wencescarlos/reloj-hyrule/AVISO_LEGAL.md

# ⚠️ Aviso legal: proyecto de fans sin ánimo de lucro

## Qué es este proyecto

**Reloj de Hyrule** es un proyecto personal, hecho en casa como regalo para un niño y como **homenaje sin ánimo de lucro** a la saga *The Legend of Zelda*. Se comparte gratis para que otras familias puedan hacer el suyo.

- ❌ **No es un producto comercial.** No se vende ni se venderá.
- ❌ **No se aceptan pagos, donaciones ni patrocinios** relacionados con este proyecto.
- ❌ **No es oficial.** No está creado, aprobado, patrocinado ni relacionado de ningún modo con **Nintendo**, ni con ninguna otra empresa ni sus licenciatarios.
- ✅ Es un proyecto educativo y familiar, de electrónica, impresión 3D y programación.

## Marcas registradas

*The Legend of Zelda*, *Zelda*, *Hyrule*, *Link*, *Trifuerza (Triforce)* y los personajes, nombres y logotipos relacionados son **marcas registradas y propiedad de Nintendo**. Se mencionan solo para identificar el tema del homenaje, sin intención de infringir ningún derecho ni de crear confusión sobre su origen.

## Qué es original en este repositorio

Para evitar cualquier confusión o acusación de plagio, aquí se detalla qué es de creación propia y qué pertenece a otros autores.

| Parte | Autoría | Licencia |
|---|---|---|
| Código del firmware (`firmware/RelojHyrule/`) | **Original**, escrito desde cero para este proyecto. No copia código de otros proyectos | CC BY-NC-SA 4.0 |
| Fuente de letras y dibujos en píxeles (`arte.py`, `fuente.h`, `sprites.h`) | **Original**, dibujado a mano píxel a píxel. No usa sprites, imágenes ni recursos de los juegos | CC BY-NC-SA 4.0 |
| Frases y textos del reloj | **Originales**, salvo algunas referencias breves a frases populares de la saga, a modo de homenaje | CC BY-NC-SA 4.0 |
| Página de configuración | **Original** | CC BY-NC-SA 4.0 |
| Carcasa v2 (`cuerpo_piedra.stl`, `tapa_trasera.stl`, `tapa_trasera_zumbador.stl`, `ventana_difusora.stl`, `barras_sujecion_matriz.stl`, `soporte_wemos.stl`, `soporte_wemos_zumbador.stl`, Trifuerzas doradas) y `generar_modelos.py` | **Originales**, diseñados desde cero | CC BY-NC-SA 4.0 |
| Letras del logo | **De geektoybox** (ver abajo), usadas con su licencia | CC BY-NC 4.0 |
| Música y sonidos | El reloj **no reproduce ninguna música ni sonido** de los juegos. Las melodías del zumbador opcional (`sonido.cpp`) son **composiciones originales** de este proyecto | CC BY-NC-SA 4.0 |

## Créditos a otros autores

| Obra | Autor original | Licencia | Cómo se usa |
|---|---|---|---|
| *Legend of Zelda Logo Text* | **geektoybox**: [Printables](https://www.printables.com/model/499505-legend-of-zelda-logo-text) | CC BY-NC 4.0 | Se incluye **sin cambios** (`logo_letras_geektoybox.stl`). Su contorno se usa para el fondo (`fondo_logo.stl`) y la cresta de la carcasa, y las letras forman parte del logo en una pieza (`logo_dos_colores.stl`). |

Se respeta la licencia CC BY-NC 4.0 del logo: se cita al autor y no hay ningún uso comercial. Las piezas derivadas del logo se comparten con la licencia **CC BY-NC-SA 4.0**, que mantiene ambas condiciones.

Si eres autor de alguna de estas obras y prefieres que se retire o se cambie el crédito, abre un *issue* y se hará enseguida.

## Prohibido el uso comercial

La licencia **CC BY-NC-SA 4.0** (Reconocimiento-NoComercial-CompartirIgual) **prohíbe expresamente**:

- Vender el código, los modelos 3D o los relojes fabricados con este proyecto.
- Usarlo en productos, servicios, tiendas (Etsy, Wallapop, Amazon, Cults...) o campañas con ánimo de lucro.

## Retirada de contenido

Si eres titular de algún derecho (incluido Nintendo) y consideras que algún contenido de este repositorio no debe estar publicado, **abre un *issue* o escribe al autor** y se retirará **sin discusión y de inmediato**.

---

*Este aviso explica la intención del proyecto y da crédito a quien corresponde. No es asesoramiento legal.*
