wencescarlos/reloj-hyrule/imagenes/vista_previa_github.png

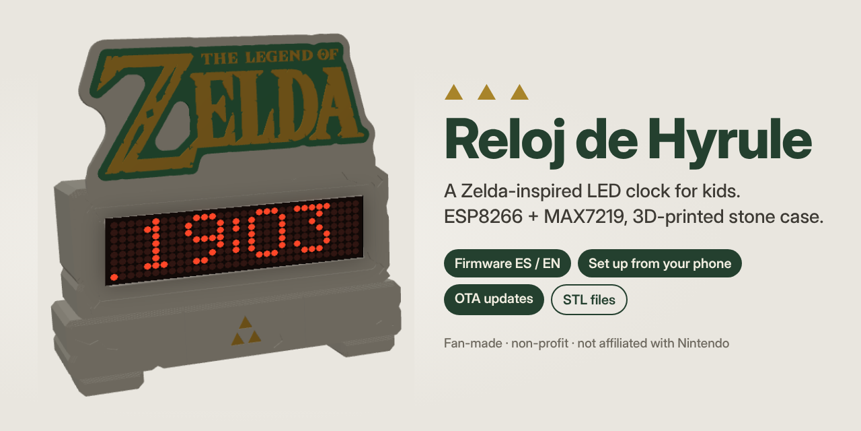
imagenes/vista_previa_github.png
