wencescarlos/reloj-hyrule/modelos_3d/soporte_wemos_zumbador_sin_pines.stl

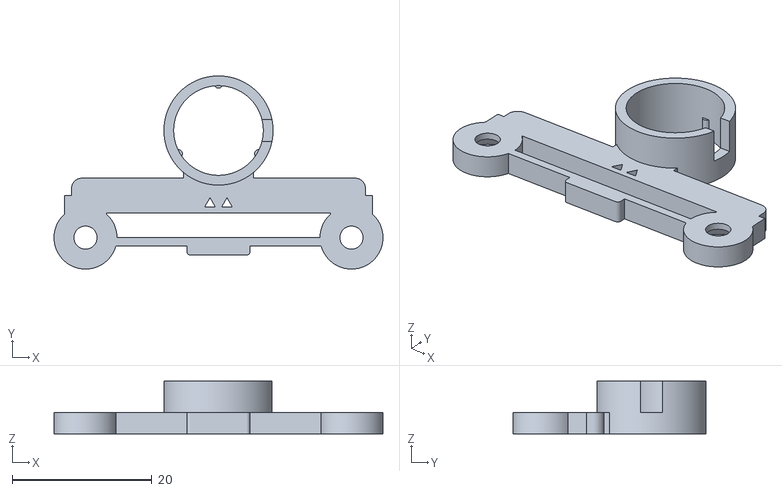
[picture p13: CAD file, 2026-11-02]
modelos_3d/soporte_wemos_zumbador_sin_pines.stl
47.0 x 27.6 x 7.50
