wencescarlos/reloj-hyrule/modelos_3d/tapa_trasera_zumbador.stl

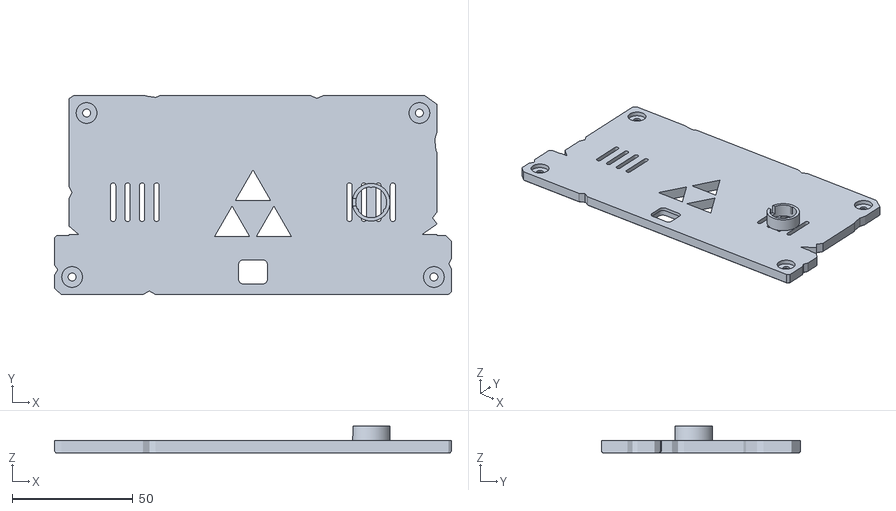
[picture p14: CAD file, 2026-11-02]
modelos_3d/tapa_trasera_zumbador.stl
164.6 x 82.6 x 11.0
