wencescarlos/reloj-hyrule/modelos_3d/soporte_wemos_zumbador.stl

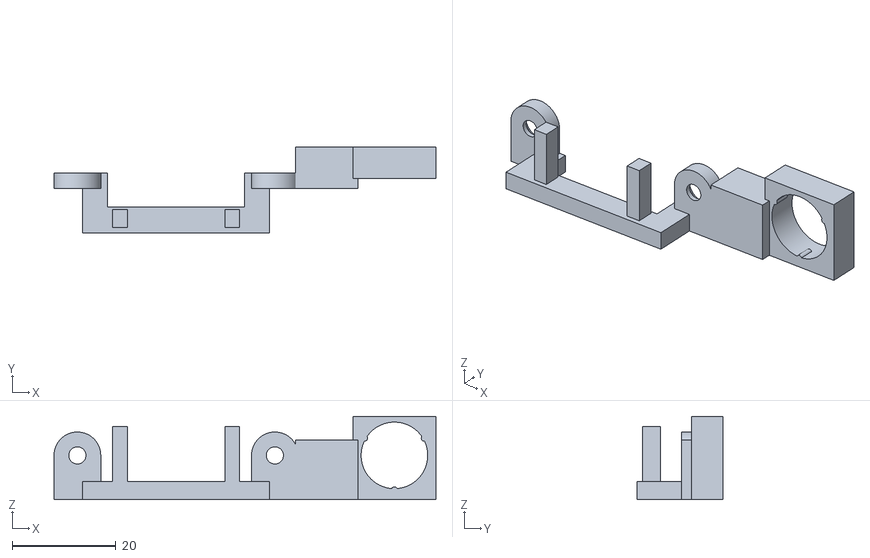
[picture p15: CAD file, 2026-11-02]
modelos_3d/soporte_wemos_zumbador.stl
73.5 x 16.5 x 16.0
