wencescarlos/reloj-hyrule/modelos_3d/ventana_difusora.stl

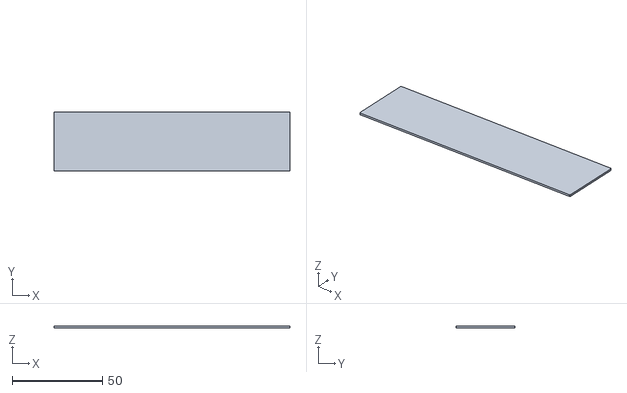
[picture p16: CAD file, 2026-10-25]
modelos_3d/ventana_difusora.stl
131.0 x 33.0 x 1.00
