wencescarlos/reloj-hyrule/modelos_3d/cuerpo_piedra.stl

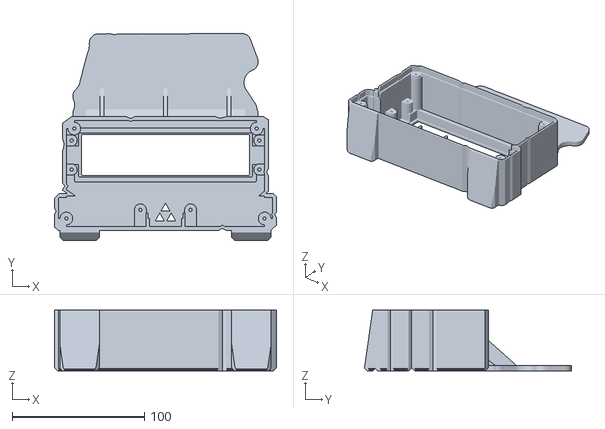
[picture p17: CAD file, 2026-10-25]
modelos_3d/cuerpo_piedra.stl
168.0 x 156.7 x 46.0
