wencescarlos/reloj-hyrule/modelos_3d/logo_dos_colores.stl

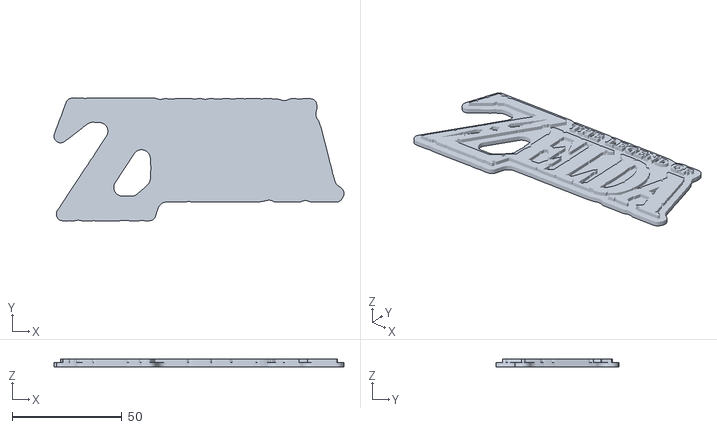
[picture p18: CAD file, 2026-10-24]
modelos_3d/logo_dos_colores.stl
132.2 x 56.0 x 3.50
