wencescarlos/reloj-hyrule/modelos_3d/tapa_trasera.stl

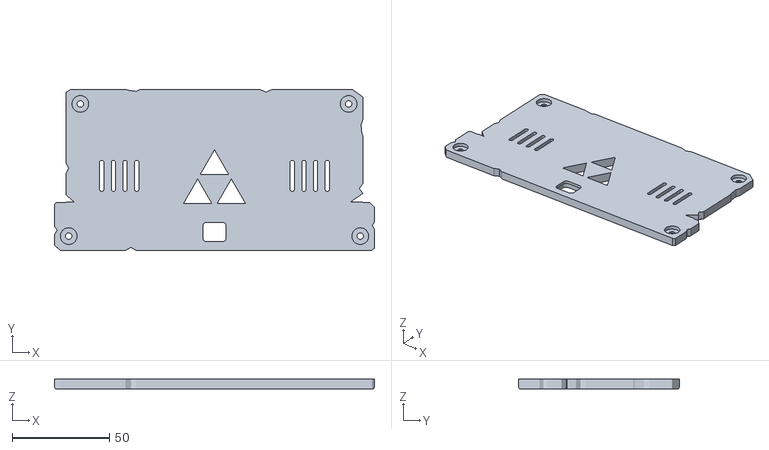
[picture p19: CAD file, 2026-10-19]
modelos_3d/tapa_trasera.stl
164.6 x 82.6 x 5.00
