wencescarlos/reloj-hyrule/modelos_3d/barras_sujecion_matriz.stl

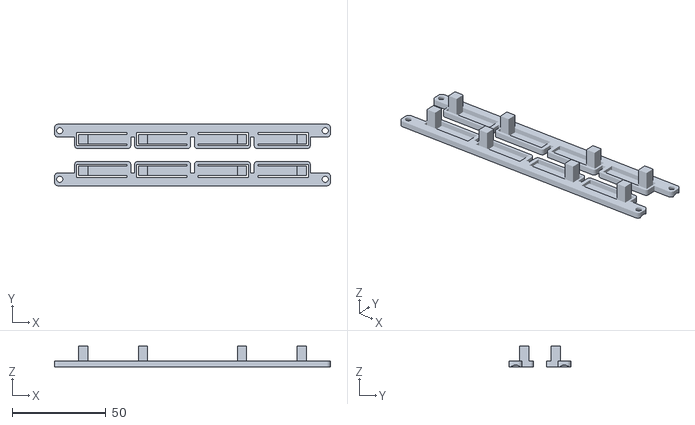
[picture p20: CAD file, 2026-10-19]
modelos_3d/barras_sujecion_matriz.stl
147.6 x 33.0 x 11.0
