wencescarlos/reloj-hyrule/modelos_3d/fondo_logo.stl

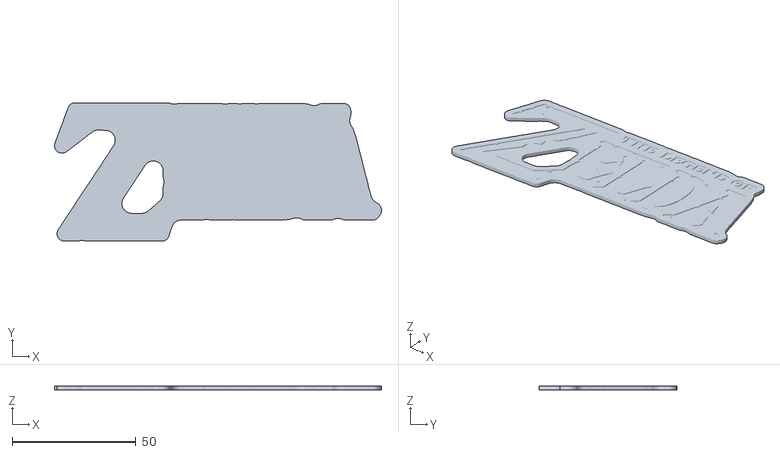
[picture p21: CAD file, 2026-10-19]
modelos_3d/fondo_logo.stl
132.2 x 56.0 x 1.60
