wencescarlos/reloj-hyrule/modelos_3d/soporte_wemos.stl

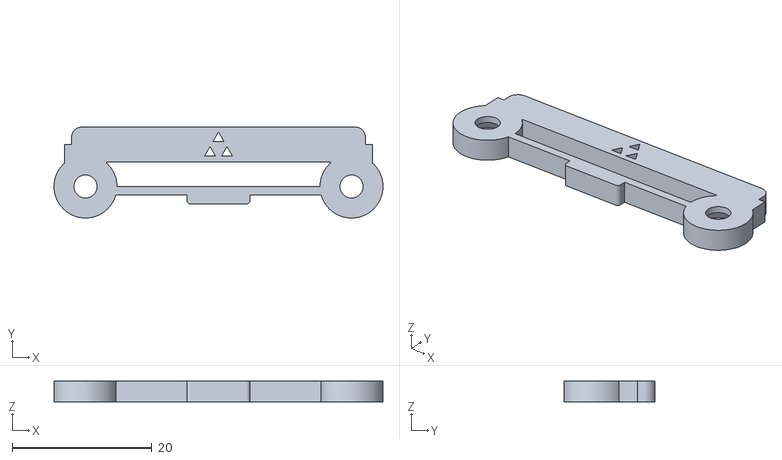
[picture p22: CAD file, 2026-10-19]
modelos_3d/soporte_wemos.stl
47.0 x 13.0 x 3.00
