wencescarlos/reloj-hyrule/modelos_3d/trifuerza_dorada_trasera.stl

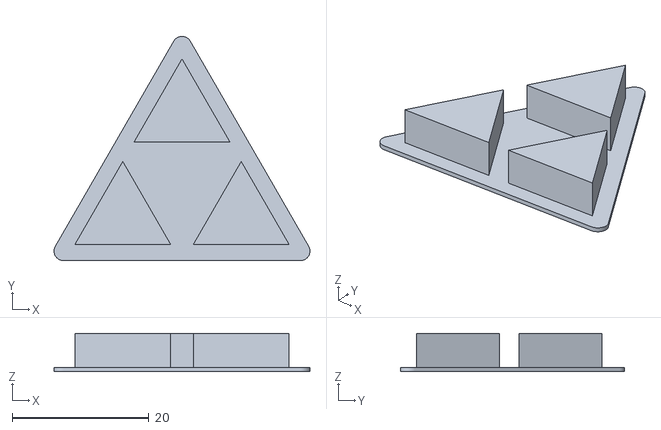
[picture p23: CAD file, 2026-10-18]
modelos_3d/trifuerza_dorada_trasera.stl
37.4 x 32.8 x 5.60
