wencescarlos/reloj-hyrule/modelos_3d/trifuerza_dorada_frontal.stl

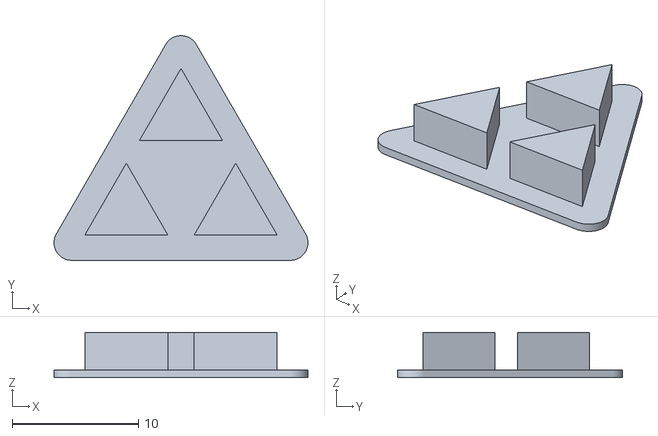
[picture p24: CAD file, 2026-10-18]
modelos_3d/trifuerza_dorada_frontal.stl
20.1 x 17.8 x 3.60
