wencescarlos/reloj-hyrule/modelos_3d/logo_letras_geektoybox.stl

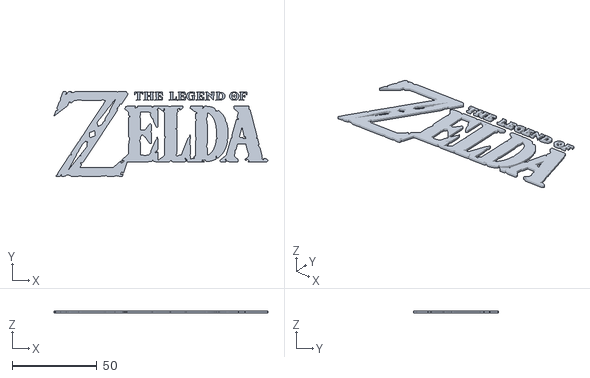
[picture p25: CAD file, 2026-10-18]
modelos_3d/logo_letras_geektoybox.stl
126.2 x 50.0 x 1.28
