wencescarlos/reloj-hyrule/firmware/RelojHyrule/fuente.h

// ===========================================================================
//  fuente.h  -  Fuente propia del Reloj de Hyrule (5x7 proporcional + tildes)
//  Reloj de Hyrule · Proyecto de fans SIN ÁNIMO DE LUCRO · No oficial
//  CC BY-NC-SA 4.0 · https://github.com/wencescarlos/reloj-hyrule
//  Cada glifo se guarda por columnas: bit 0 = fila de arriba (tildes),
//  bits 1..7 = cuerpo de la letra. Archivo generado a partir del dibujo
//  de las letras; no hace falta tocarlo a mano.
// ===========================================================================
#pragma once
#include <Arduino.h>

// Códigos internos de los caracteres especiales (además del ASCII)
#define CAR_CORAZON   0x01
#define CAR_RUPIA     0x02
#define CAR_TRIFUERZA 0x03
#define CAR_DESTELLO  0x04
#define CAR_A_TILDE   128
#define CAR_E_TILDE   129
#define CAR_I_TILDE   130
#define CAR_O_TILDE   131
#define CAR_U_TILDE   132
#define CAR_U_DIERESIS 133
#define CAR_ENIE      134
#define CAR_ABRE_EXCL 135
#define CAR_ABRE_INTERR 136
#define CAR_GRADO     137

const uint8_t FUENTE_DATOS[] PROGMEM = {
  0x18, 0x3C, 0x78, 0x3C, 0x18, 0x38, 0x7C, 0xC6, 0x7C, 0x38, 0x20, 0x30, 0x24, 0x06, 0x24, 0x30,
  0x20, 0x22, 0x14, 0x08, 0x14, 0x22, 0x00, 0x00, 0x00, 0xBE, 0x06, 0x00, 0x06, 0x24, 0x7E, 0x24,
  0x7E, 0x24, 0x46, 0x26, 0x10, 0xC8, 0xC4, 0x6C, 0x92, 0xAA, 0x44, 0xA0, 0x06, 0x7C, 0x82, 0x82,
  0x7C, 0x54, 0x38, 0x7C, 0x38, 0x54, 0x10, 0x10, 0x7C, 0x10, 0x10, 0x80, 0x40, 0x10, 0x10, 0x10,
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
  255, 255, 255, 255, 255, 255, 255, 255, 255, 255, 255, 255, 255, 255, 255, 255
};

// Letras pequeñas 3x5 para el indicador AM / PM
const uint8_t MINI_A[3] PROGMEM = {0x1E, 0x05, 0x1E};
const uint8_t MINI_P[3] PROGMEM = {0x1F, 0x05, 0x02};
