wencescarlos/reloj-hyrule/(commit log)

2026-10-18 Reloj de Hyrule v1.0.0: proyecto de fans sin ánimo de lucro
    Firmware original para Wemos D1 mini + MAX7219, piezas 3D (remezclas
    CC BY-NC 4.0 de la caja de Qrome y del logo de geektoybox, con crédito),
    Trifuerza dorada para la tapa trasera, web de actualizaciones (GitHub
    Pages) y aviso legal. No oficial; sin relación con Nintendo.
    Licencia CC BY-NC-SA 4.0.
    [base_reloj_zelda.stl, fondo_logo.stl, logo_letras_geektoybox.stl, tapa_trifuerza.stl, trifuerza_dorada.stl]
2026-10-18 Carcasa V2
    [cuerpo_piedra.stl, fondo_logo.stl, tapa_trasera.stl, trifuerza_dorada_frontal.stl, trifuerza_dorada_trasera.stl, ventana_difusora.stl]
2026-10-19 Carcasa v2.4: tornillos M3x6 avellanados sin insertos y soporte del Wemos
    - Quitada la mella triangular que atravesaba la carcasa y la tapa.
    - 10 tornillos iguales M3 x 6 autorroscantes de cabeza avellanada allen,
    sin insertos, en agujeros guía de 2,5 mm. Todos entran desde atrás.
    - La tapa se centra con bolsillos en las torretas (3 mm de tapa por tornillo).
    - Nuevo soporte_wemos.stl, atornillado desde atrás, con viga elástica que
    aprieta el blindaje del ESP. Sin pegamento.
    - Borrados los archivos de la v1 que ya no se usaban.
    - README, README.en, LEEME, esquema de tornillería e imágenes actualizados.
    Claude-Session: https://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
    [barras_sujecion_matriz.stl, base_reloj_zelda.stl, cuerpo_piedra.stl, fondo_logo.stl, soporte_wemos.stl, tapa_trasera.stl, tapa_trifuerza.stl, trifuerza_dorada.stl]
2026-10-19 Firmware 1.1.1: recupera el español y el inglés
    El commit "Carcasa V2" había devuelto el firmware a la 1.0.0 y borrado
    el trabajo del commit "English" (83b3bcf). Se recupera entero:
    - Selector de idioma Español / English en la página del reloj.
    - Frases, fecha, animaciones y página web en los dos idiomas.
    - docs/index.html, firmware/LEEME.md y animaciones en inglés.
    - README.md con el enlace a README.en.md y la opción de idioma.
    Versión 1.1.1, mayor que la 1.0.0 publicada y que la 1.1.0, para que
    todos los relojes se actualicen solos.
    Claude-Session: https://claude.ai/code/session_01WdfzgvEswNUDjf3uWauBJy
2026-10-24 Logo en una sola pieza para imprimir en dos colores con pausa
    - Nuevo modelos_3d/logo_dos_colores.stl (opción B): fondo verde de 2,0 mm
    y letras de geektoybox hasta 3,5 mm. Se cambia el filamento a 2,0 mm.
    - generar_modelos.py lo genera (función logo_dos_colores).
    - LEEME con la comparación de las dos opciones y los pasos de la pausa en
    PrusaSlicer, OrcaSlicer, Bambu Studio y Cura. READMEs, licencia y aviso
    legal actualizados.
    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
    [logo_dos_colores.stl]
2026-10-24 Firmware 1.2.0: diagnóstico de pantalla
    - Nuevo apartado "Diagnóstico de pantalla" en la página del reloj (ES/EN):
    encender todos los LED o un módulo cada vez (modo de prueba del MAX7219),
    dejar DIN, CLK o CS a 3,3 V para medirlos con el polímetro y terminar.
    Se cierra solo a los 10 minutos.
    - Patas de la pantalla configurables (DIN, CLK, CS) por si una pata del Wemos
    se estropea, y modo de señales lentas. Con DIN=D7 y CLK=D5 sigue usando el
    SPI del chip; con otras patas, las señales se generan por programa.
    - /api/estado informa de las patas y del diagnóstico. El puerto serie lo
    escribe al arrancar.
    - README: aviso de soldar en la entrada (DIN) de la matriz y cómo usar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
2026-10-25 Firmware 1.2.1: arregla la pantalla apagada (CS en D6)
    CS está en D6 (GPIO12), que es la pata MISO del SPI del ESP8266.
    Pantalla::iniciar() la configuraba como salida ANTES de SPI.begin(), y
    SPI.begin() la convertía en MISO: CS no cambiaba nunca y la matriz no
    aceptaba ninguna orden. Ahora CS se configura después de SPI.begin().
    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
    [configuracion.h, pantalla.cpp]
2026-10-25 Firmware 1.2.2: asistente de orientación de la pantalla
    - En "Pantalla", un asistente recorre las 8 posiciones (giro x espejo) con
    un solo botón: guarda cada posición y enseña 1 2 3 4 durante 6 segundos.
    - /api/prueba?corta=1: solo los números, sin flecha ni texto.
    - El apartado de orientación sale abierto.
    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
2026-10-25 Carcasa: cabe la matriz de 130 mm y la ventana difusora se puede colocar
    - El alojamiento de la matriz pasa de 128,8 x 32,8 a 131,4 x 33,4 mm:
    valen las placas 4 en 1 de 128 a 130 mm.
    - La ventana difusora medía 133 x 37 mm y no pasaba por el marco. Ahora
    mide 131 x 33 x 1 mm: entra por el mismo hueco que la matriz y cae en un
    rebaje de 1 mm del frente. La matriz la aprieta; no se pega.
    - LEEME: nuevo paso de montaje de la ventana con imagen.
    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
    [cuerpo_piedra.stl, ventana_difusora.stl]
2026-10-25 Firmware 1.2.3: la pantalla se recupera sola si se desconfigura
    El Wemos envía señales de 3,3 V y el MAX7219 a 5 V pide al menos 3,5 V,
    así que alguna orden puede llegar mal (calor, ruido, bajones del WiFi) y
    dejar un módulo con caracteres raros hasta reiniciar. Ahora la
    configuración completa (prueba, decodificar, filas, brillo y encendido) se
    reenvía cada segundo desde mostrar(), y el brillo y el encendido se
    recuerdan para reenviarlos igual.
    README: consejos de montaje para una pantalla estable (condensador, cables
    cortos, cargador de 1 A).
    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
2026-10-25 Firmware 1.2.4: arregla el botón de enviar un mensaje
    La función del botón se llamaba igual que la casilla del texto
    (mensajeYa). Dentro del formulario, el navegador encontraba antes la
    casilla que la función y el botón daba el error "mensajeYa is not a
    function": el mensaje no se enviaba nunca.
    - La función pasa a llamarse enviarMensajeYa; aviso pasa a mostrarAviso
    por el mismo motivo (también coincidía con un id).
    - Ahora también se envía al pulsar Intro en la casilla.
    Probado en Chromium con un servidor que imita la API del reloj: todos los
    botones envían su petición y no hay errores en la página.
    Claude-Session: http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
    [configuracion.h, pagina_web.h]
2026-10-25 Firmware 1.3.0: página de mensajes para el móvil (/mensaje)
    - Nueva página http://reloj-hyrule.local/mensaje, pensada para añadirla a
    la pantalla de inicio del iPhone (icono, pantalla completa, zonas seguras)
    y de Android (manifiesto):
    · mensaje propio o rápido, con botón para añadir el nombre del niño;
    · quién lo trae: héroe, hada, cofre, corazones, Trifuerza, bomba,
    sorpresa o una aventura completa;
    · tiempo en pantalla (1 vez, 30 s ... 10 min) y velocidad;
    · vista previa con la fuente y los dibujos reales del reloj;
    · botón para parar con la cuenta atrás; recuerda los últimos mensajes.
    - /api/mensaje admite intro, segundos y velocidad; /api/mensaje/para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
2026-10-25 Firmware 1.4.0: modo concentración, sonido con zumbador y alarma
    Modo concentración
    - Solo la hora, quieta: sin parpadeo, sin segundos, sin fecha, sin
    aventuras, saludos ni animaciones de la hora. Los mensajes enviados a mano
    sí se ven.
    - A mano (25/45/60/120 min o sin límite) desde la página principal y la del
    móvil, o con horario semanal de estudio. Al terminar, aviso opcional con
    melodía y "¡BUEN TRABAJO, {N}!".
    Sonido (zumbador pasivo opcional en D1)
    - Reproductor sin bloqueo por PWM, volumen 1-10 con el ciclo de trabajo.
    - 8 melodías ORIGINALES (Aventura, Campanitas, Amanecer, Victoria, Aviso,
    Misterio, Marcha, Nana). El reloj no reproduce música de los juegos.
    - So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
    [tapa_trasera.stl]
2026-10-25 Carcasa: dos tapas traseras, con y sin zumbador
    - tapa_trasera.stl vuelve a ser la tapa lisa, sin aro.
    - Nueva tapa_trasera_zumbador.stl con el aro para el zumbador opcional.
    - generar_modelos.py crea las dos (tapa(con_zumbador=True)).
    - README, README.en, LEEME, aviso legal y licencia: se elige una de las dos.
    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
    [tapa_trasera.stl, tapa_trasera_zumbador.stl]
2026-10-25 Carcasa: soporte del Wemos con aro para el zumbador
    - Nuevo soporte_wemos_zumbador.stl: el mismo soporte con un aro encima del
    larguero donde el zumbador de 12 mm entra a presión por detrás. Queda
    dentro del pedestal, junto a D1 y G.
    - Comprobado con el montaje completo: no toca la carcasa, el marco de la
    matriz, las barras, el Wemos ni la tapa (0,5 mm hasta el marco).
    - generar_modelos.py: soporte_wemos(con_zumbador=True).
    - Documentación: dos sitios posibles para el zumbador.
    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
    [soporte_wemos_zumbador.stl]
2026-10-26 Firmware 1.4.1: pantalla más estable al desplazar texto
    Al desplazar texto se envían unas 30 imágenes por segundo, y con señales
    de 3,3 V hacia un MAX7219 a 5 V algún bit puede llegar mal: salen píxeles
    sueltos o un módulo se desconfigura.
    - La configuración (prueba, decodificar, filas, brillo y encendido) se
    reenvía con cada imagen, no cada segundo: un módulo desconfigurado se
    arregla en la imagen siguiente.
    - SPI a 500 kHz (antes 1 MHz) y a 125 kHz con "Señales lentas", que ahora
    sigue usando el SPI del chip con las patas de fábrica (antes iba a mano).
    - README: arreglo de hardware definitivo con un 74AHCT125.
    Claud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
    [configuracion.h, pantalla.cpp]
2026-10-26 Firmware 1.4.2: deshace el cambio de pantalla de la 1.4.1 y sube el brillo
    - La 1.4.1 reenviaba la configuración del MAX7219 con cada imagen. En
    matrices con chips compatibles, cada orden de configuración reinicia el
    barrido de las filas: las letras se veían peor y la pantalla más apagada.
    Ahora se reenvía cada 2 segundos (en la 1.4.0 era cada segundo).
    - SPI otra vez a 1 MHz, como en las versiones que iban bien. "Señales
    lentas": 250 kHz con el SPI del chip.
    - Brillo de fábrica 6 (antes 2) para verse bien con la ventana difusora; la
    nota de la página recomienda de 5 a 8 de día.
    Claude-Session: https://claude.ai/code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
2026-10-26 Firmware 1.4.3: mensajes claros al buscar una versión nueva
    - "Ya tienes la última versión (x). En internet: y." para que se vea qué
    versión hay publicada.
    - Los errores se explican: 404 (no publicada, revisar GitHub Pages),
    -1 (no conecta), -11 (tarda demasiado).
    - "Buscando..." mientras comprueba.
    - El puerto serie informa de la versión publicada y de la memoria libre.
    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
    [actualizacion.cpp, configuracion.h]
2026-10-26 Firmware 1.4.4: evita bucles de reinicio al buscar actualizaciones
    - La comprobación por HTTPS necesita mucha memoria. Antes de conectar se
    mira el mayor bloque libre; si no llega a 22 KB, no se intenta y la página
    lo explica.
    - Se deja una marca en la memoria RTC mientras se comprueba. Si el reloj se
    reinicia en mitad, al arrancar lo detecta y aplaza la comprobación
    automática un día: ya no puede entrar en un bucle de reinicios.
    - La página enseña el motivo del último reinicio, el tiempo encendido y la
    memoria libre. El puerto serie también escribe el motivo al arrancar.
    Claude-Session: https://claude.ai/code/sessio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
2026-10-26 Firmware 1.4.5: tras actualizarse dice "Actualizado", no "colgado"
    Cuando el reloj encontraba una versión nueva, se reiniciaba en mitad de la
    comprobación y la marca de "comprobando" se quedaba puesta: al arrancar
    creía que se había colgado. Ahora el reinicio lo hace el propio código
    después de dejar una marca de "actualizado", y la página dice
    "✓ Actualizado por internet a la versión x".
    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
2026-10-26 Firmware 1.4.6: el aviso de "colgado" solo sale si hubo un fallo de verdad
    La marca de "comprobando" saltaba con cualquier reinicio que pasara durante
    la comprobación de versiones, también los voluntarios (botón, WiFi, subida
    desde PlatformIO, instalación de una versión). Ahora solo cuenta si el
    motivo del reinicio es un fallo del programa o un bloqueo (excepción o
    watchdog).
    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
2026-10-26 Firmware 1.4.7: memoria para las actualizaciones por HTTPS
    "No conecta" al buscar versiones: la conexión segura con GitHub necesita un
    búfer de 16,7 KB más unos 11 KB para el cifrado, y con ~28 KB libres no
    llegaba. La librería BearSSL del núcleo ya pone su búfer en la segunda
    zona de memoria (IRAM) si existe.
    - Compilación con MMU "16KB cache + 48KB IRAM and 2nd Heap (shared)":
    platformio.ini (PIO_FRAMEWORK_ARDUINO_MMU_CACHE16_IRAM48_SECHEAP_SHARED),
    GitHub Actions (mmu=4816H) y las instrucciones del Arduino IDE. El código
    en IRAM ocupa 30 KB de 48: quedan unos 18 KB para el búfer.
    - La comprobación mira la memoria de las dos zonas antes de conectar.
    - Si falla, el mensaje i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
2026-10-26 Carcasa: soporte_wemos_zumbador.stl para Wemos con pines y placa del zumbador
    Con tiras de pines y conectores dupont en el Wemos, la barra del soporte
    chocaba con los conectores. El nuevo soporte_wemos_zumbador.stl:
    - se atornilla en las mismas torretas, desde atrás (2 x M3 x 6);
    - cruza por encima del Wemos solo en la punta de la antena y por arriba
    (y > 20,5 mm), lejos de los conectores;
    - aprieta la placa con dos patas en sus esquinas libres (0,3 mm);
    - lleva a un lado dos guías con ranura para una placa perforada de
    26,5-29,5 mm con el zumbador, que entra deslizando desde arriba.
    Comprobado con el montaje: no toca la carcasa, el ESP, los conectores, el
    USB, la matriz ni la tapa, y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
    [soporte_wemos_zumbador.stl]
2026-10-26 Carcasa: soporte_wemos_zumbador.stl con aro para el propio zumbador
    En lugar de guías para la placa, un aro de 12,4 mm con tres nervios donde el
    zumbador entra a presión (por delante, con el agujero hacia la tapa). Si va
    soldado en una placa pequeña, la placa cuelga de él hacia el frente: hay
    sitio para una de 28 x 20 mm. La parte que esquiva los pines del Wemos no
    cambia. Comprobado con el montaje: sin choques y con acceso a los tornillos.
    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
    [soporte_wemos_zumbador.stl]
2026-10-26 Firmware 1.4.8: marca RTC fuera de la zona de actualizaciones y pitido de prueba
    - La marca de "comprobando/actualizado" se guardaba en el bloque 0 de la
    memoria RTC de usuario, donde el sistema guarda la orden de instalar una
    actualización (primeros 128 bytes): podía pisarla. Ahora va en el bloque 64.
    - Sonido: botones de pitido continuo de 10 s (1 kHz y 2,5 kHz) al 50 % para
    oír el zumbador o medir la señal en D1 con el polímetro.
    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
2026-11-02 Firmware 1.5.0: versión para producción
    Páginas
    - Nuevo "Menú de pruebas (avanzado)", cerrado de forma predeterminada al
    final de la página: estado del sistema, diagnóstico de pantalla, patas,
    señales lentas y pruebas del zumbador. Así no confunde a quien solo usa
    el reloj.
    - El sonido es un añadido opcional: viene desactivado de fábrica y, si no
    está activado, sus opciones no aparecen en ninguna página (volumen y
    melodías, melodía de la alarma, "Sonido del aviso" del móvil y pruebas
    del zumbador). Se activa en Sonido → "Tengo un zumbador conectado".
    - La alarma funciona también sin zumbador (mensaje de buenos días); su
    duración pasa a llamarse "Cuánto dura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
2026-11-02 Repositorio: historial de cambios, plantillas, insignias y CI en pull requests
    - CHANGELOG.md con todas las versiones (1.0.0 → 1.5.0) y la carcasa
    - CONTRIBUTING.md, plantillas de incidencias (fallo / idea) y de pull request
    - .gitattributes: STL e imágenes binarias, páginas incrustadas fuera de las estadísticas
    - Workflow: compila también en pull requests (sin publicar) y acciones actualizadas
    - README: insignias, enlace a Releases y al historial
    - Quita imágenes PNG duplicadas que no se usaban
    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
2026-11-02 Workflow de releases: firmware y piezas 3D al subir una etiqueta v*
    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
2026-11-02 Workflow de releases: también se lanza a mano desde Actions
    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
2026-11-02 CHANGELOG: nombre exacto de la casilla del sonido
    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
2026-11-02 Carcasa: el aro ya no estruja el zumbador
    El aro de soporte_wemos_zumbador.stl y tapa_trasera_zumbador.stl apretaba
    el cilindro (nervios hasta 11,5 mm) y el zumbador casi no sonaba. Ahora el
    hueco es de 12,8 mm y tres nervios cortos, solo junto a la base, lo rozan
    a 12,1 mm sin apretar.
    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
    [soporte_wemos_zumbador.stl, tapa_trasera_zumbador.stl]
2026-11-02 Carcasa: soporte_wemos_zumbador_sin_pines.stl con el aro corregido
    Recupera el soporte normal del Wemos (sin pines) con aro para el zumbador,
    que se había sustituido por la versión para pines. El aro ya no estruja el
    zumbador: hueco de 12,8 mm y nervios que solo lo rozan en el grosor del soporte.
    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
    [soporte_wemos_zumbador_sin_pines.stl]
2026-11-02 Créditos: quita la mención a Marquee Scroller (no se usa nada suyo)
    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
2026-11-02 Enlace a Printables e imagen de vista previa para GitHub
    - Insignia y enlace a la página de Printables en los README, en modelos_3d/LEEME.md y en la web
    - imagenes/vista_previa_github.png (1280x640) para Settings -> Social preview
    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
